jerryxfu/laptop-stand/preview/exploded.png

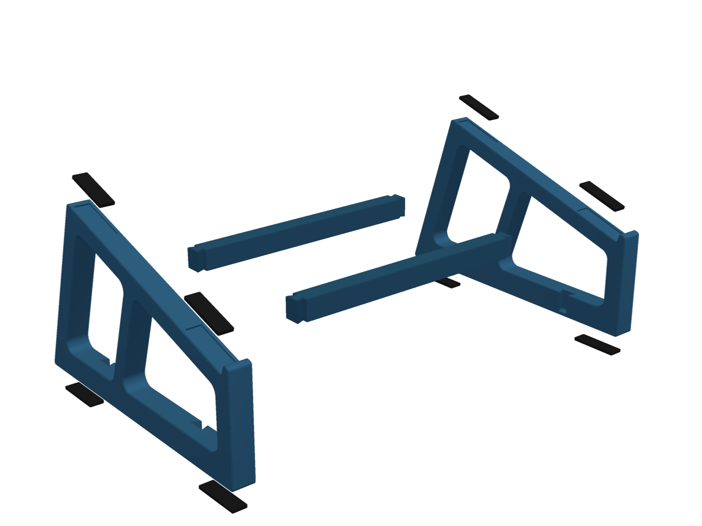
preview/exploded.png
