jerryxfu/laptop-stand/preview/side_view.png

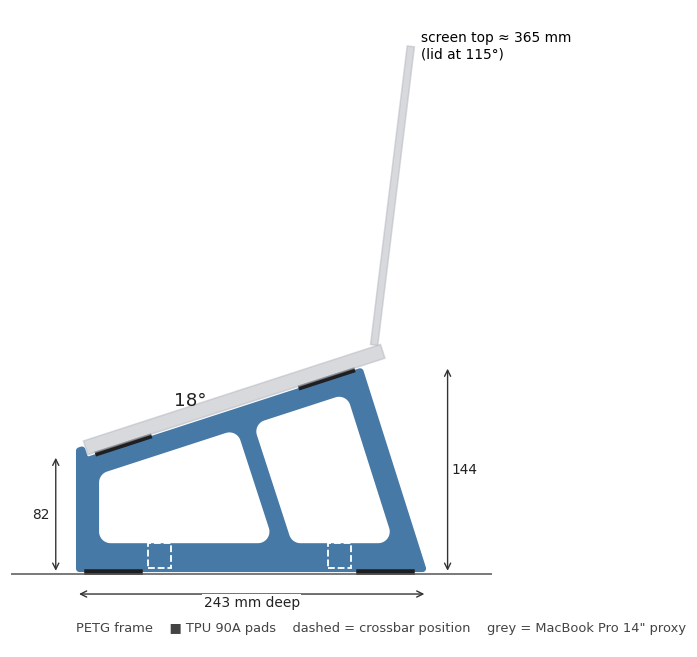
preview/side_view.png
