jerryxfu/laptop-stand/preview/stand_front.png

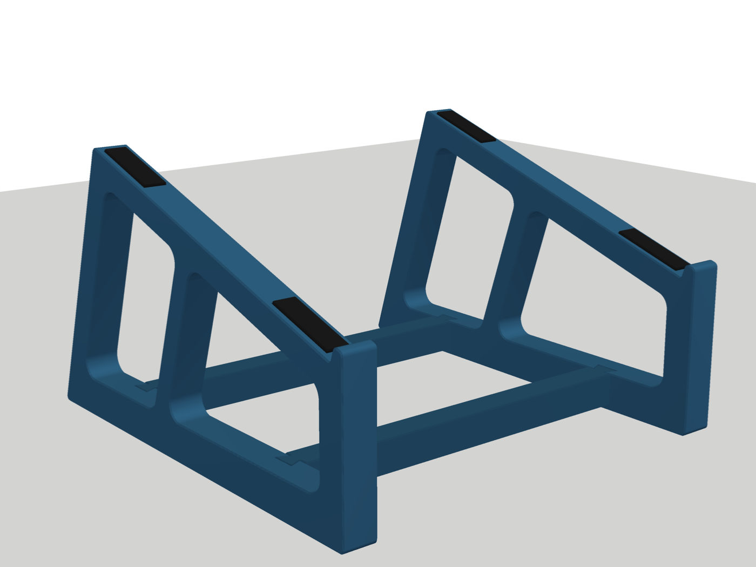
preview/stand_front.png
