jerryxfu/laptop-stand/preview/stand_rear.png

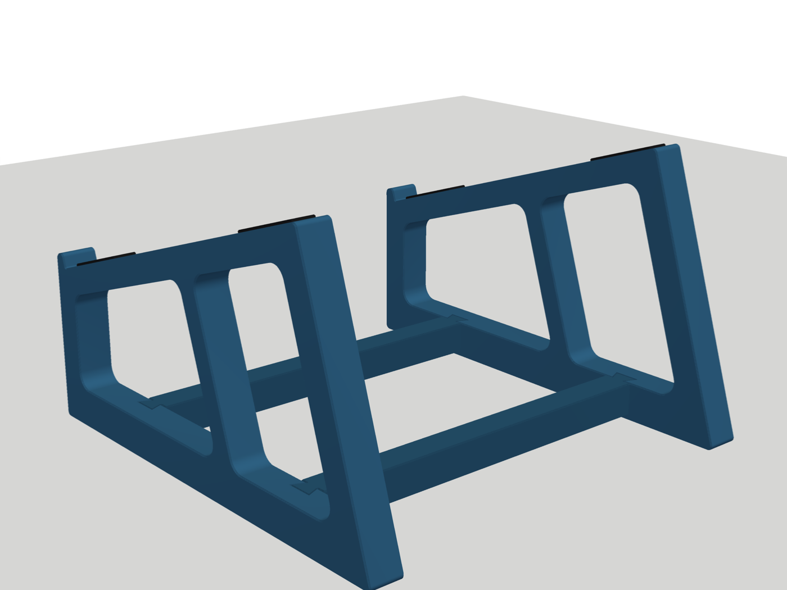
preview/stand_rear.png
