jerryxfu/laptop-stand/bambu/fit_test_PETG.3mf

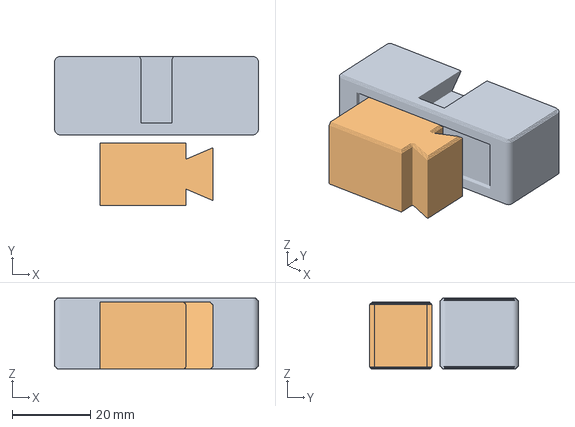
[picture p6: CAD file, 2026-11-08]
bambu/fit_test_PETG.3mf
52.0 x 38.0 x 18.0 mm
fit_test_socket.stl
fit_test_tenon.stl
