jerryxfu/laptop-stand/stl/fit_test_tenon.stl

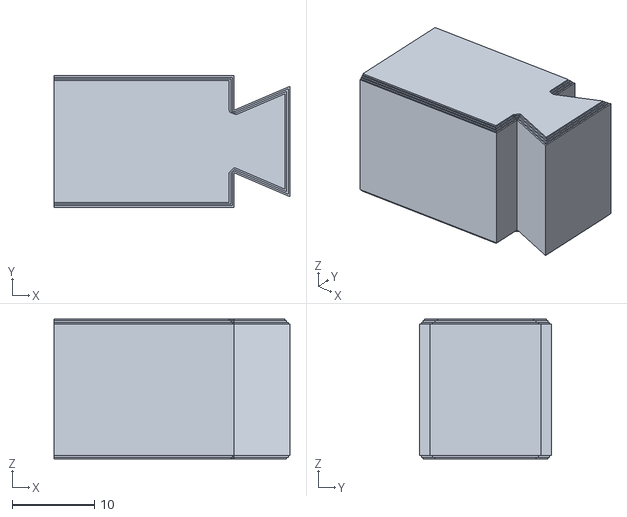
[picture p7: CAD file, 2026-11-08]
stl/fit_test_tenon.stl
28.7 x 16.0 x 17.0
