jerryxfu/laptop-stand/bambu/riser_PETG_frames_crossbars.3mf

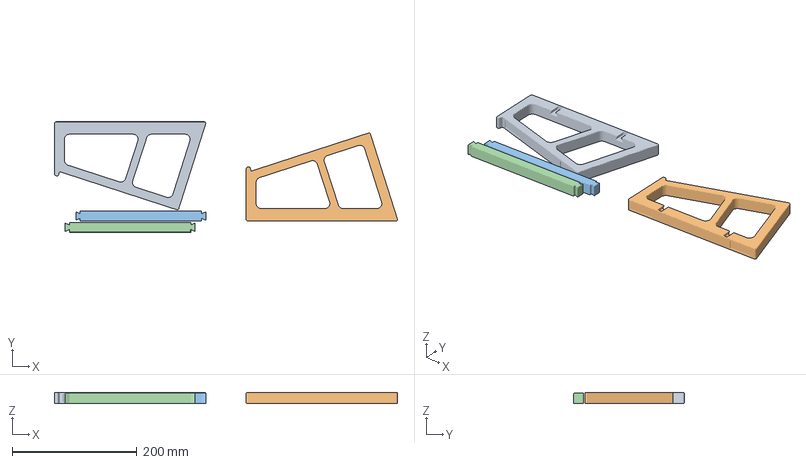
[picture p8: CAD file, 2026-11-08]
bambu/riser_PETG_frames_crossbars.3mf
549.7 x 177.1 x 18.0 mm
frame_right.stl
frame_left.stl
crossbar_x2.stl x 2
