jerryxfu/laptop-stand/stl/tpu_pad_x8.stl

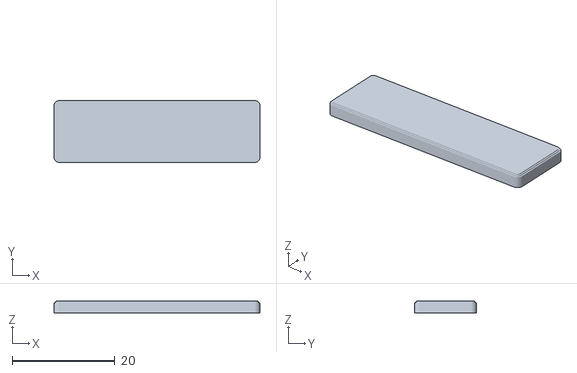
[picture p9: CAD file, 2026-11-08]
stl/tpu_pad_x8.stl
40.0 x 12.0 x 2.40
