jerryxfu/laptop-stand/bambu/riser_TPU90A_pads_x8.3mf

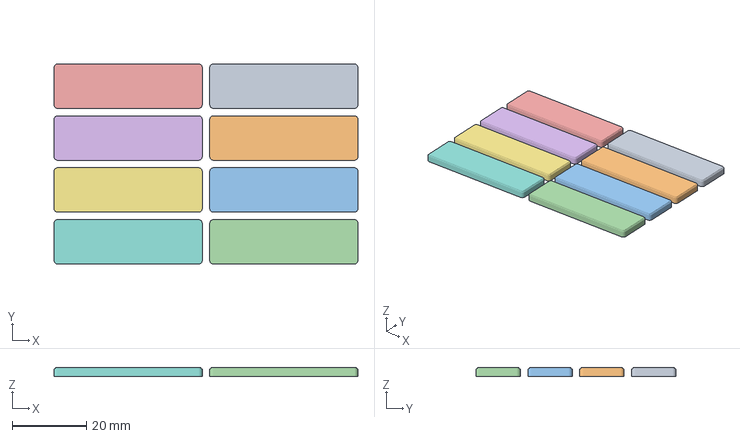
[picture p10: CAD file, 2026-11-08]
bambu/riser_TPU90A_pads_x8.3mf
82.0 x 54.0 x 2.40 mm
tpu_pad_x8.stl x 8
