jerryxfu/laptop-stand/stl/crossbar_x2.stl

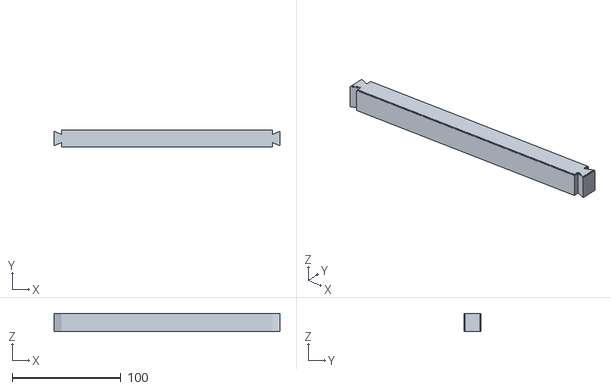
[picture p11: CAD file, 2026-11-08]
stl/crossbar_x2.stl
208.2 x 16.0 x 17.0
