jerryxfu/laptop-stand/stl/frame_left.stl

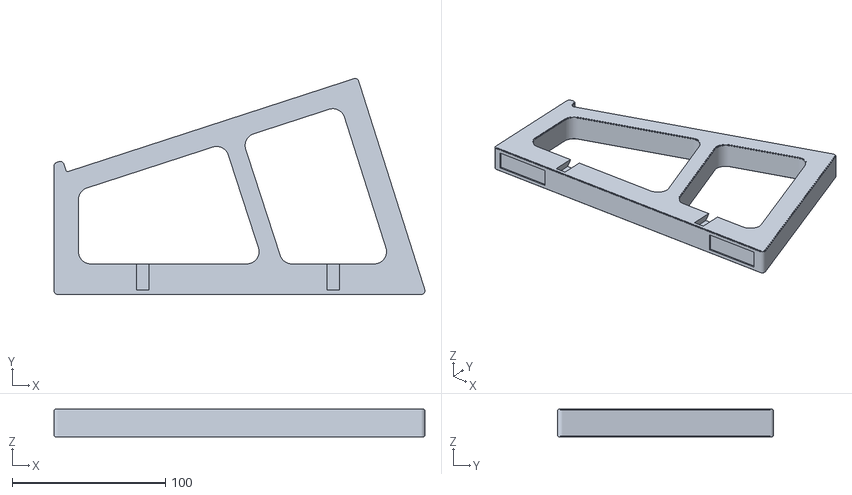
[picture p12: CAD file, 2026-11-08]
stl/frame_left.stl
242.5 x 141.1 x 18.0
