jerryxfu/laptop-stand/stl/fit_test_socket.stl

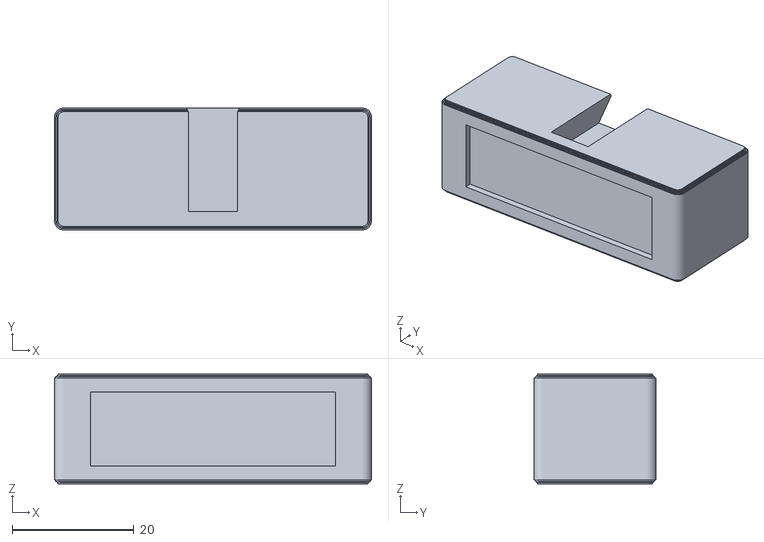
[picture p13: CAD file, 2026-11-08]
stl/fit_test_socket.stl
52.0 x 20.0 x 18.0
