jerryxfu/laptop-stand/(list of files, cad)

Other CAD files:
stl/frame_right.stl
