jerryxfu/laptop-stand/preview/print_plates.png

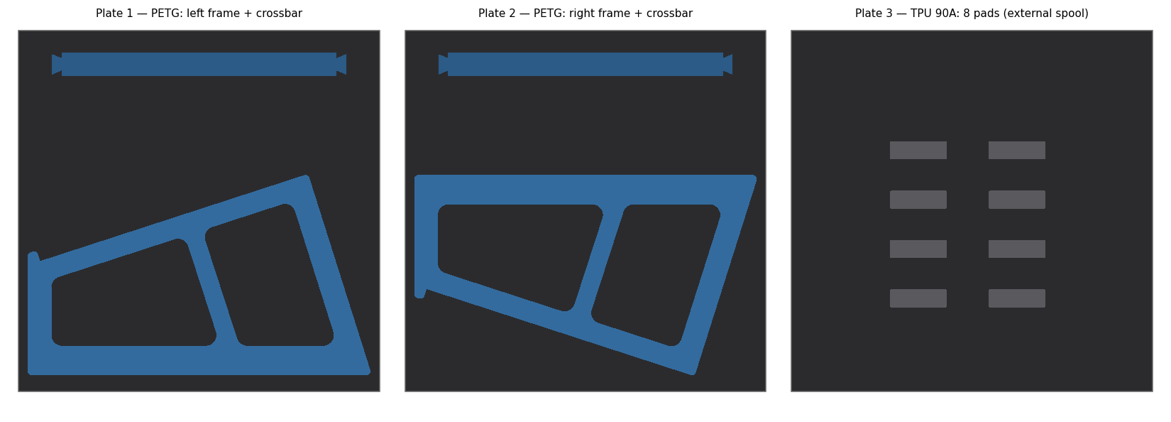
preview/print_plates.png
