jerryxfu/laptop-stand/(commit log)

2026-11-08 Add parametric MacBook Pro 14" PROLED riser
    Two PETG side frames joined by dovetailed crossbars, with TPU 90A pads.
    Includes the generator script, STLs, sliced Bambu X1C projects, a fit
    test and preview renders.
    [crossbar_x2.stl, fit_test_PETG.3mf, fit_test_socket.stl, fit_test_tenon.stl, frame_left.stl, frame_right.stl, riser_PETG_frames_crossbars.3mf, riser_TPU90A_pads_x8.3mf]
2026-11-08 Add setup, slicing script and handoff notes
    - requirements.txt and a Makefile (setup, stl, preview, slice, all)
    - tools/slice_bambu.py rebuilds the bambu/ projects with the Bambu Studio CLI
    - render_preview.py now uses the parameters of the last STL build and
    writes next to the script; dropped the unused matplotlib 3D renderer
    - CLAUDE.md records the owner's setup, design decisions, gotchas and
    open work (foot seats, higher crossbar, license, fit test)
    - README gains new-machine setup, make commands and a status section
